dividia-dev/axle-measurement/(commit log)

2026-05-08 Initial commit: CV Axle Controller + Measurement Web App
    Physical controller (Arduino Pro Micro) with dual joysticks for positioning
    measurement lines on live video to measure truck axle distances. Browser-based
    web app with calibration, Federal Bridge Formula weight calculator (FL Statute
    316.535), JWT auth, and measurement history.
    Components:
    - Arduino firmware (Pro Micro USB HID + Uno serial prototype)
    - Node.js/Express web app with SQLite, Canvas overlay, weight compliance
    - Research docs: camera measurement, auto-calibration, Spot Decoder analysis
    - 50 unit tests, all passing
2026-05-09 UI improvements: calibration mode, line visibility, feet+inches input
    - Calibration panel moved to compact bottom-right overlay (not blocking video)
    - Tomato-colored border + lines during calibration mode
    - Lines now have black outline for visibility on both light and dark backgrounds
    - Distance input changed from single field to separate feet + inches fields
    - "Special" label changed to "Dump/Mix" with tooltip explaining FL special vehicle cap
    - Video container gets tomato border in calibration mode
2026-05-09 Add coarse/fine toggle mode with on-screen indicator
    - F key toggles between COARSE (blue) and FINE (amber) movement modes
    - On-screen indicator at bottom center shows current mode
    - A/D and J/L keys use whichever mode is active (no separate fine keys needed)
    - Simplified control hints in bottom bar
    - Updated Pro Micro firmware default: joystick button sends 'f' for toggle
    - Updated serial bridge key map to match
2026-05-09 Fix: use normalized coordinates for window-size-independent measurements
    Critical bug: calibration stored pixel values that were tied to the window
    size at calibration time. Resizing the browser changed the measurement
    without moving the lines.
    Fix: all measurement math now uses normalized coordinates (0-1) relative
    to the video frame. The calibration stores inches_per_normalized_unit
    instead of pixels_per_inch. The measurement is now:
    distance = |line2_norm - line1_norm| * inches_per_norm
    This is completely independent of window size, browser resize, or display
    resolution. Same line positions always produce the same measurement.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
2026-05-09 Update docs with accuracy analysis, architecture, and project status
    - Complete rewrite of PROJECT_NOTES.md with accuracy analysis, system
    architecture, calibration procedure, bridge formula reference, and
    full component inventory
    - Updated memory files with accuracy feedback and current project state
    - Documented physical accuracy limits: +/- 2-3 inches (1080p), +/- 1-2 inches (4K)
    - Documented why this is sufficient for bridge formula (whole-foot rounding)
    - Added git log to project notes
2026-05-09 Fix: formatDistance rounding bug (19 ft 12 in → 20 ft)
    Math.round(inches % 12) could round 11.6 up to 12, displaying
    "19 ft 12 in" instead of "20 ft". Fixed by rounding total inches
    first, then dividing into feet and remainder.
    Also fixed calibration input: empty inches field treated as 0,
    inches-only input (no feet) works correctly.
2026-05-09 Swap panel positions, remove unused Settings button
    - Weight/axle panel moved to top-right
    - Calibration status moved to top-left
    - Removed Settings button (no functionality planned — calibration
    and key mappings already have their own entry points)
2026-05-09 Consolidate all controls into right side panel
    All interactive controls now in a single vertical strip on the right:
    - Axle count +/- buttons
    - Dump/Mix checkbox
    - Max weight display
    - Save / Reset buttons
    - Coarse/Fine mode indicator
    - Keyboard hints at the bottom
    Video area is uncluttered — only shows measurement readout,
    calibration status, and the lines. Removed the old bottom bar
    with scattered controls.
2026-05-09 UX improvements: reorder panel, clickable mode toggle, mouse drag for lines
    - Max weight moved above axle input (most important info first)
    - Axle input now closer to Save button (less movement)
    - Added spacing between axle row and Dump/Mix checkbox
    - COARSE/FINE is now a clickable button (in addition to F key)
    - Added mouse drag for measurement lines — diamond drag handles at
    line centers, click and drag left/right to reposition
    - Cursor changes to ew-resize when hovering near a line
    - All 51 tests passing
2026-05-09 Save axle count, max weight, and screenshot with each measurement
    - Measurements now store axle_count, max_weight_lbs, is_special_vehicle
    - Screenshot captured on save: video frame cropped to actual content
    (no black bars, no UI), with just the blue measurement lines drawn
    (no drag handles or labels). Saved as JPEG to data/screenshots/
    - History table updated: shows Distance, Axles, Max Weight, Operator,
    and a "View" link to open the screenshot
    - DB schema auto-migrates (adds new columns if missing)
    - Express body limit increased to 5mb for base64 screenshot data
    - 51 tests passing
2026-05-09 Add confirmation dialog and data overlay on screenshots
    - Save button now shows a confirmation dialog with measurement summary
    (distance, axles, max weight) before saving — prevents accidental duplicates
    - Screenshots now include data overlay in upper-right corner:
    date/time, vehicle length, axle count, max allowable weight
    - Overlay uses semi-transparent black background with white monospace text
    - Font size scales with video resolution
    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
2026-05-09 Update docs and memory with current project state
    - PROJECT_NOTES.md updated with all new features: mouse drag, screenshot
    overlay, confirmation dialog, side panel layout, complete git log
    - Memory updated with UX feedback (group controls, confirm saves,
    multiple input methods)
    - Project overview updated with current feature list
2026-05-09 Add download button to history screenshot rows
2026-05-09 Add product workflow doc with full V1 scope, FDOT permit details, and ticket integration
    Documents end-to-end workflow from permit ingestion through scale weighing
    to image capture and cloud portal. Includes FDOT PAS portal URLs, FastWeigh
    JSON webhook integration alongside existing Command Alkon XML, and NVR
    ScaleWatcher thread integration notes.
2026-05-09 Fix calibration mode: instant rendering, restore line positions, pre-fill inputs
    - Call drawOverlay() on calibration toggle so line colors and border
    update instantly instead of waiting for next user interaction
    - Move calibration border to ::after pseudo-element with z-index 20
    so it renders on top of video content
    - Save/restore line positions when entering/exiting calibration mode
    so operator's measurement positions are preserved
    - Pre-fill feet/inches inputs from current calibration data
    - On save, lines return to pre-cal positions with new calibration applied
2026-05-09 UI polish: live clock, centered panel, toggle switch, local time in history
    - Add live date/time clock to top of side panel
    - Center panel labels, weight value, and axle row
    - Replace Dump/Mix checkbox with iOS-style toggle switch
    - Toggle label goes bold white when active for visibility
    - Move CALIBRATED indicator from video overlay to top bar
    - Convert history timestamps from UTC to local time
    - Add vertical spacing between keyboard shortcut hints
    - Increase panel label font sizes for readability
2026-05-09 Add GitHub Pages demo: landing page + interactive sessionStorage app
    Landing page at docs/index.html with project overview, features, and specs.
    Full interactive demo at docs/demo/ that runs entirely client-side:
    - Bridge Formula B calculated in-browser (no backend needed)
    - SessionStorage replaces database (clears when tab closes)
    - Test pattern generated via canvas as default video source
    - Users can load their own video/image files for testing
    - Storage meter shows sessionStorage usage
    - All features work: calibration, measurement, weight calc, history, screenshots
2026-05-09 Clean up test pattern: remove labels, add overlay reference markers
    - Remove axle labels (Steer/Drive/Trailer), yellow arrows, foot scale
    - Remove horizontal background lines and subtitle text
    - Add two orange reference markers drawn on overlay (not in screenshots)
    - Markers positioned at first/last axle for calibration reference
    - Hide reference markers when user loads their own video/image
2026-05-09 Narrow reference markers, add Dump/Mix info button
    - Center and halve the width of reference markers (0.34-0.58)
    - Add info button (i) next to Dump/Mix toggle in both demo and main app
    - Shows alert explaining FL 316.535 special vehicle 70,000 lb cap
2026-05-09 Tighten reference markers to 1/4 original width, centered on truck
    Markers now at 0.37-0.49 (span=0.12) vs original 0.22-0.70 (span=0.48).
    Positioned between axle 2 and 3 on the test pattern truck.
2026-05-09 Default 10ft calibration so demo works immediately on load
    No more "NOT CALIBRATED" on first visit. Default calibration uses
    the reference marker span (0.37-0.49) as 10ft. Users can still
    recalibrate anytime via the Calibrate button.
2026-05-09 Change default calibration to 20ft across reference markers
2026-05-09 Tighten ref markers (0.42-0.50), 10ft default calibration
    Markers now span 0.08 normalized, centered on trailer mid-section.
    10ft calibration across that span makes the truck proportionally
    ~72ft, realistic for a 5-axle semi.
2026-05-09 Fix default calibration: validate saved data before using it
    Check that saved calibration has inches_per_norm before trusting it,
    otherwise fall back to DEFAULT_CALIBRATION. Prevents stale/empty
    sessionStorage entries from blocking the default.
2026-05-09 Fix screenshot capture: prefer test-pattern canvas, add error fallback
    captureStream video frames aren't always drawable. Use the test-pattern
    canvas directly as the screenshot source in demo mode. Added try/catch
    fallback for user-loaded media edge cases.
2026-05-09 Fix View button (blob URL), add Bridge Formula info icon
    - View button now converts data URL to blob URL, which browsers allow
    in new tabs (data: URLs in target=_blank are blocked for security)
    - Added info icon (i) next to MAX WEIGHT in both demo and main app
    - Clicking shows the full Bridge Formula B calculation with current
    values: formula, inputs, result, applied cap, and all cap thresholds
2026-05-09 Replace weight info alert with proper modal
    Full-width modal shows Bridge Formula B with formula, inputs,
    step-by-step calculation, result, applied cap, all cap thresholds,
    and a plain-English explanation. Closes with button or Escape.
2026-05-09 Add Reset Image button to restore default test pattern
    Appears after loading custom video/image. Hides again after reset.
2026-05-09 Fix Clear Data: restore default calibration instead of null
2026-05-09 Clear Data only clears measurement history, preserves calibration
2026-05-09 Always show Reset Image button
2026-05-09 Only show Reset Image button after loading custom media
2026-05-09 Add controller settings UI with key mapping, sensitivity, and live test
    Configurable key bindings and joystick sensitivity via a new Settings modal
    (admin-only). The Arduino controller stays dumb — the web app maps incoming
    keycodes to actions using a reverse lookup. Includes a Controller Test tab
    with an SVG joystick diagram that lights up when inputs register, useful for
    verifying dead zones and connectivity. Settings persist in SQLite (web app)
    or sessionStorage (demo app). 60 tests pass (9 new).
2026-05-09 Cancel key capture when clicking outside the capture button
    Clicking anywhere in the settings modal that isn't a key capture button
    now cancels the active capture and restores the previous binding.
    Previously the only way to cancel was pressing Escape.
2026-05-09 Add input stats to Controller Test tab for dead zone testing
    Shows keystroke count, rate/sec, and last action detected above the
    joystick diagram. Helps operators find the dead zone threshold by
    pushing slowly and watching when inputs register. Clear button resets.
2026-05-09 Add dead zone auto-calibration to Arduino firmware
    Hold a joystick button for 3 seconds to auto-calibrate that joystick's
    dead zone. The Arduino samples resting noise for 2 seconds, sets the
    dead zone to noise peak + margin, and saves to EEPROM. Each joystick
    calibrates independently. LED blinks fast during calibration, goes
    solid to confirm.
    Also adds serial commands: DZ (show dead zones), DZ 1 60 40 (manual set),
    CAL 1/2 (trigger calibration), RAW (show analog readings). Center point
    is now calibrated per-joystick instead of hardcoded at 512.
    [axle_controller_pro_micro.ino]
2026-05-09 Fix firmware RAM usage: 87% down to 20% using F() macro and C-strings
    Replaced Arduino String class with fixed char buffers and converted all
    Serial.println string literals to F() macro (flash storage instead of RAM).
    Also condensed printKeys output format. RAM usage dropped from 2240 bytes
    (320 free, stability risk) to 523 bytes (2037 free, stable).
    [axle_controller_pro_micro.ino]
2026-05-09 Add close button to settings modal header
    X button in upper right corner of the settings modal for quick dismiss
    without scrolling to the bottom Cancel button.
2026-05-09 Light up joystick center circle on input, pad Reset to Defaults buttons
    The center dot in the controller test diagram now lights up blue along
    with the directional arrow when input is detected. Added left/right
    padding to Reset to Defaults buttons so text doesn't hug the edges.
2026-05-09 Fix joystick center circle not lighting up on input
    The center circle wasn't activating because rapid keydown/keyup events
    from the Arduino's repeat rate would toggle the active class off
    immediately. Now tracks active keys per joystick — the center stays
    lit as long as any direction key for that joystick is held.
2026-05-09 Show "Configuration saved" confirmation after saving settings
    Green text fades in next to Save button, fades out after 2 seconds.
    Gives clear feedback that the save succeeded without closing the modal.
2026-05-10 Add hardware controller concept sketches and link from main app
    SVG mockups showing the 3D-printed enclosure from 4 angles (top, front,
    3/4 perspective, rear) with all components: dual JH-D400X-R4 joysticks,
    3 LEDs (2x blue fine mode, 1x red/green lock), micro flip switch, USB-C.
    Includes two layout variants for lock LED placement. Linked from top bar.
2026-05-10 Add controller mockup links to GitHub Pages landing page
    Button in hero section and inline link in Hardware Controller feature card
    both point to docs/controller-mockup.html.
2026-05-10 Move mockup link to Hardware Controller card as button, remove hero button
2026-05-10 Add touch/tablet support: pointer events for line drag, fullscreen button
    Replace mouse-only drag with unified Pointer Events API (pointerdown/move/up)
    that works for mouse, touch, and pen. Wider 30px hit zone for touch. Add
    fullscreen toggle button to hide browser chrome on tablets. CSS: touch-action
    none on overlay, dvh viewport units, safe-area-inset padding, mobile web app
    meta tags.
2026-05-10 Replace native confirm/alert with in-app dialogs, add mobile keyboard support
    Native confirm() and alert() force exit from fullscreen mode. Replace all
    instances with custom in-app modal dialogs (appConfirm/appAlert) that stay
    in fullscreen. Add inputmode="numeric" on calibration inputs for number pad.
    Add hidden text input that triggers virtual keyboard during key capture on
    touch devices. Add no-cache meta tags to demo page.
2026-05-10 Add breadboard wiring guide with schematic, pin table, and parts list
    Interactive HTML page with canvas-drawn wiring schematic showing Arduino
    Pro Micro connected to 2x JH-D400X-R4 joysticks, 3 LEDs with resistors,
    and lock switch. Includes pin-by-pin wiring table with wire colors,
    parts list, breadboarding notes, and testing checklist. Linked from
    docs landing page.
2026-05-13 Rewrite controller firmware v2.0 with state machine and ratchet fine mode
    Clean rewrite from scratch replacing the patched v1 firmware. Key changes:
    - Per-joystick state machine (IDLE/COARSE/FINE/SUPPRESSED) replaces scattered globals
    - Ratchet fine mode: fires on increasing twist deflection, silent on decrease,
    direction locked until return to dead zone
    - EMA low-pass filter, hysteresis (engage 30/disengage 12), coarse suppression
    after fine, 100+ dead zone floor, button fires on release
    - 33 offline simulation tests covering ghost keystrokes, ratchet behavior,
    crosstalk isolation, EMA filter, asymmetric fine travel
    - Compiles at 56% flash, 24% RAM for arduino:avr:leonardo
    Also adds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
    [axle_controller_pro_micro.ino, bare_minimum_test.ino, joystick_diagnostic.ino, single_joystick_test.ino, test_state_machine.cpp]
2026-05-13 Firmware v2.1: button-toggle fine mode, demo fine keys, line crossing prevention
    Firmware changes:
    - Replace twist-barrel fine mode with button-toggle fine/coarse per joystick
    (twist axis disabled, unreliable for bidirectional fine control)
    - Dedicated recal button on D8 runs full calibration on both joysticks
    - Simplified state machine: no FINE/SUPPRESSED states, no crosstalk suppression
    - Unified button handler fixes J1 inconsistent press detection
    - 49% flash, 20% RAM
    Demo app changes:
    - Add direct fine key actions (Q/E for line 1, U/O for line 2)
    - Fine keys always move at fine step regardless of toggle state
    - Settings modal organized by joystick with fine key bindings
    - Controller t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
    [axle_controller_pro_micro.ino]
2026-05-13 Add 3D-printable enclosure design with OpenSCAD model and panel layouts
    Two-piece enclosure (190x100x42mm) for Bambu Lab A1, 0.4mm nozzle:
    - Parametric OpenSCAD source with top/bottom shell generation
    - Sealed design (no vents) for dusty cement facility environment
    - Friction-fit structural pillars for alignment and center support
    - Filleted top edges, engraved branding (AXLE CONTROLLER / DIVIDIA)
    - Interactive HTML layout planners for top, back, and bottom panels
    - Component spec with all caliper-measured dimensions
    - Build instructions in enclosure/README.md (no STLs in repo)
    [enclosure.scad]
2026-05-14 Enclosure v2: test print feedback — step joint, 8 screws, corrected measurements
    11 revisions from first test print:
    - Step (rabbet) joint replacing failed nesting lip (no supports needed)
    - 8x M3 screws (4 corners + 4 center, replacing friction-fit pillars)
    - Height 42mm → 47mm for internal clearance
    - USB-C mount corrected: 16mm spacing, 4.5mm standoffs, M2.5, cable recess
    - Perfboard standoff inset corrected: 3mm → 2mm
    - Joystick screw holes widened: 2.8mm → 3.8mm for assembly ease
    - Status LED moved 14mm toward back for toggle clearance
    - Recal pinhole upgraded to recessed target ring (8mm, professional look)
    - Top labels: LOCK, FINE with dashes, AXLE TRACKER moved to back
    - Back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
    [enclosure.scad]
2026-05-14 Add joystick axis restrictor — Y-axis only gate plate
    Replaces stock 19mm circular gate with 13mm vertical slot to physically
    block X-axis travel. Reinforcement ribs flank the slot on the interior
    surface. Parametric OpenSCAD model with full measurement documentation.
    [joystick-restrictor.scad]
2026-05-14 Enclosure v2: recal button mount, USB-C standoff fix, toggle hole resize
    - Add recal button mount posts + pocket on back wall interior for 6x6mm
    tactile switch, with printable retention plate (prongs wrap button sides)
    - Extend recal pinhole through pocket material so paperclip reaches button
    - Fix USB-C standoffs: OD 5→5.5mm (won't fall through PCB holes),
    ID 3.2→2.2mm (tap hole instead of clearance), height 4.5→3.5mm
    (board sits 1mm below port cutout)
    - Fix cable recess depth: 6→2.5mm (no longer punches through wall)
    - Toggle switch hole: 11.5→13mm diameter (+1.5mm)
    [enclosure.scad]
2026-05-15 Enclosure v3: test print feedback — 10 fixes from v2 evaluation
    Snap-in cradle replaces screw-post recal button mount (prong clearance,
    deeper pocket). Bottom boss height corrected for step joint overlap.
    FINE dashes replaced with pointer triangles. Deeper deboss for cleaner
    print on vertical walls. Fillet sphere resolution increased to eliminate
    junction ridge. Restrictor slot parameterized with two test variants
    (12mm, 11mm) and debossed variant numbers.
    SCAD changes:
    - Recal: snap-in cradle with flex tabs, open sides for prongs
    - Bottom bosses: subtract STEP_H (7mm → 5mm)
    - FINE: dash lines → triangle pointers (◀ FINE ▶)
    - Deboss depths: 0.6 → 1.0mm (text), 1.5 → 2.0mm (rec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
    [enclosure.scad, joystick-restrictor.scad]
2026-05-16 Dual-color lock LED (D5 red/D9 green), perfboard docs, board test sketch
    Firmware: drive both RGB LED channels — D5 red when locked, D9 green when
    unlocked. Inverted lock switch reading to match upside-down toggle mount.
    Added perfboard layout tool, Wago wiring plan, PCB spec/schematic for
    future board fabrication, EasyEDA walkthrough, and a board test sketch
    for verifying pin-to-terminal continuity without components connected.
    [axle_controller_pro_micro.ino, board_test.ino]
2026-05-18 Firmware v2.2: startup animation, dimmed RGB, lock fix, J1 swap, recal when locked
    - Startup: alternating blue LEDs during calibration, clean lock LED on ready
    - 10mm RGB LED dimmed via PWM (analogWrite ~24% brightness)
    - Lock switch: red=locked, green=unlocked, joysticks work when green
    - J1 left/right keys swapped (joystick mounted reversed)
    - Recal button works when locked
    - EEPROM magic bumped to force key reload
    - Added recal cradle test print piece for iterating snap-in fit
    [recal-cradle-test.scad]
2026-05-18 Live video: WSPlayer integration, Dividia Cloud/NVR auth, Video Source settings
    Web app + demo: add live video streaming via WSPlayer (WebSocket H.264)
    - Video Source tab in Settings: Dividia Cloud or Local NVR login
    - Auth proxied through Express (/api/nvr/auth, /api/nvr/auth-local) to
    avoid CORS — supports cloud /ve/auth and local NVR JSON-RPC
    - Camera dropdown auto-populated from auth response, profile selector
    - WSPlayer renders inside video-container under measurement overlay
    - getVideoRect() and captureScreenshot() work with WSPlayer canvas
    - Demo served at /demo via Express for proxy access
    WSPlayer fixes (forked copy, not upstream):
    - Force hardware decoding on every page load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
2026-05-18 Controller test: lock/fine LED state, per-joystick fine keys, UI cleanup
    Firmware v2.2:
    - Add 3 new key slots: K_LOCK, K_J1_FINE_LED, K_J2_FINE_LED for
    hardware state reporting via keystrokes
    - Send lock key on switch transitions (not every loop)
    - Send fine-LED key on fine enable, button key on fine disable
    - Announce lock state on startup (host assumes unlocked + coarse)
    - Bump EEPROM magic (0xB5) for layout change, NUM_KEYS 10→13
    Controller Test UI:
    - Lock indicator with red/green LEDs matching physical 10mm RGB
    - Per-joystick blue fine mode LEDs matching D6/D7
    - Removed outdated "twist = fine" text
    - Hold-to-light: arrows stay lit during rapid HID keystrokes (150ms hold)
    - Global to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
2026-05-18 Controller test: fix fine LED state tracking, hide Save/Cancel on test tab
    - Track per-joystick hardware fine state (hwFineState) independently
    from browser's global state.fineMode — fine LED stays lit until
    hardware button toggles it off
    - Fine LED no longer cleared by joystick keyup timeouts
    - Hide Save/Cancel buttons on Controller Test tab (not applicable)
    - Keep Save/Cancel on Video Source tab (saves to localStorage)
